IanFeldman/watch/hw/schematic.png

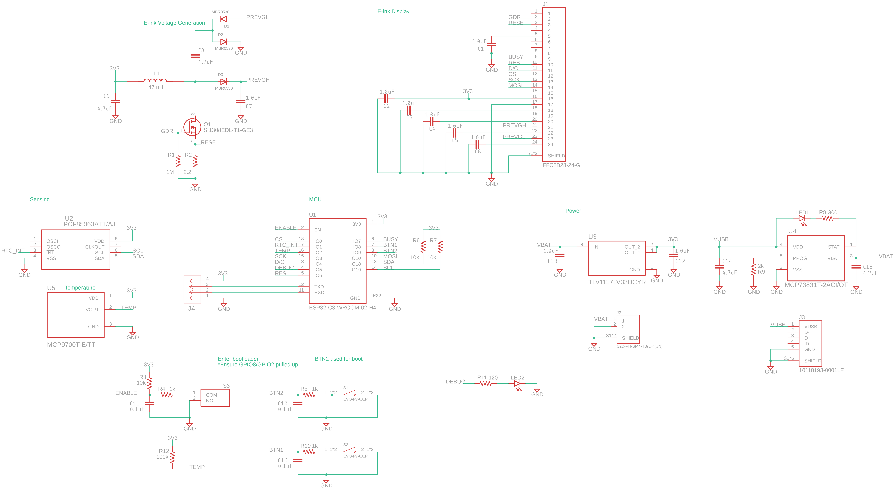
hw/schematic.png
