IanFeldman/watch/hw/v1.brd

## EAGLE design hw/v1.brd (2024-08-28)

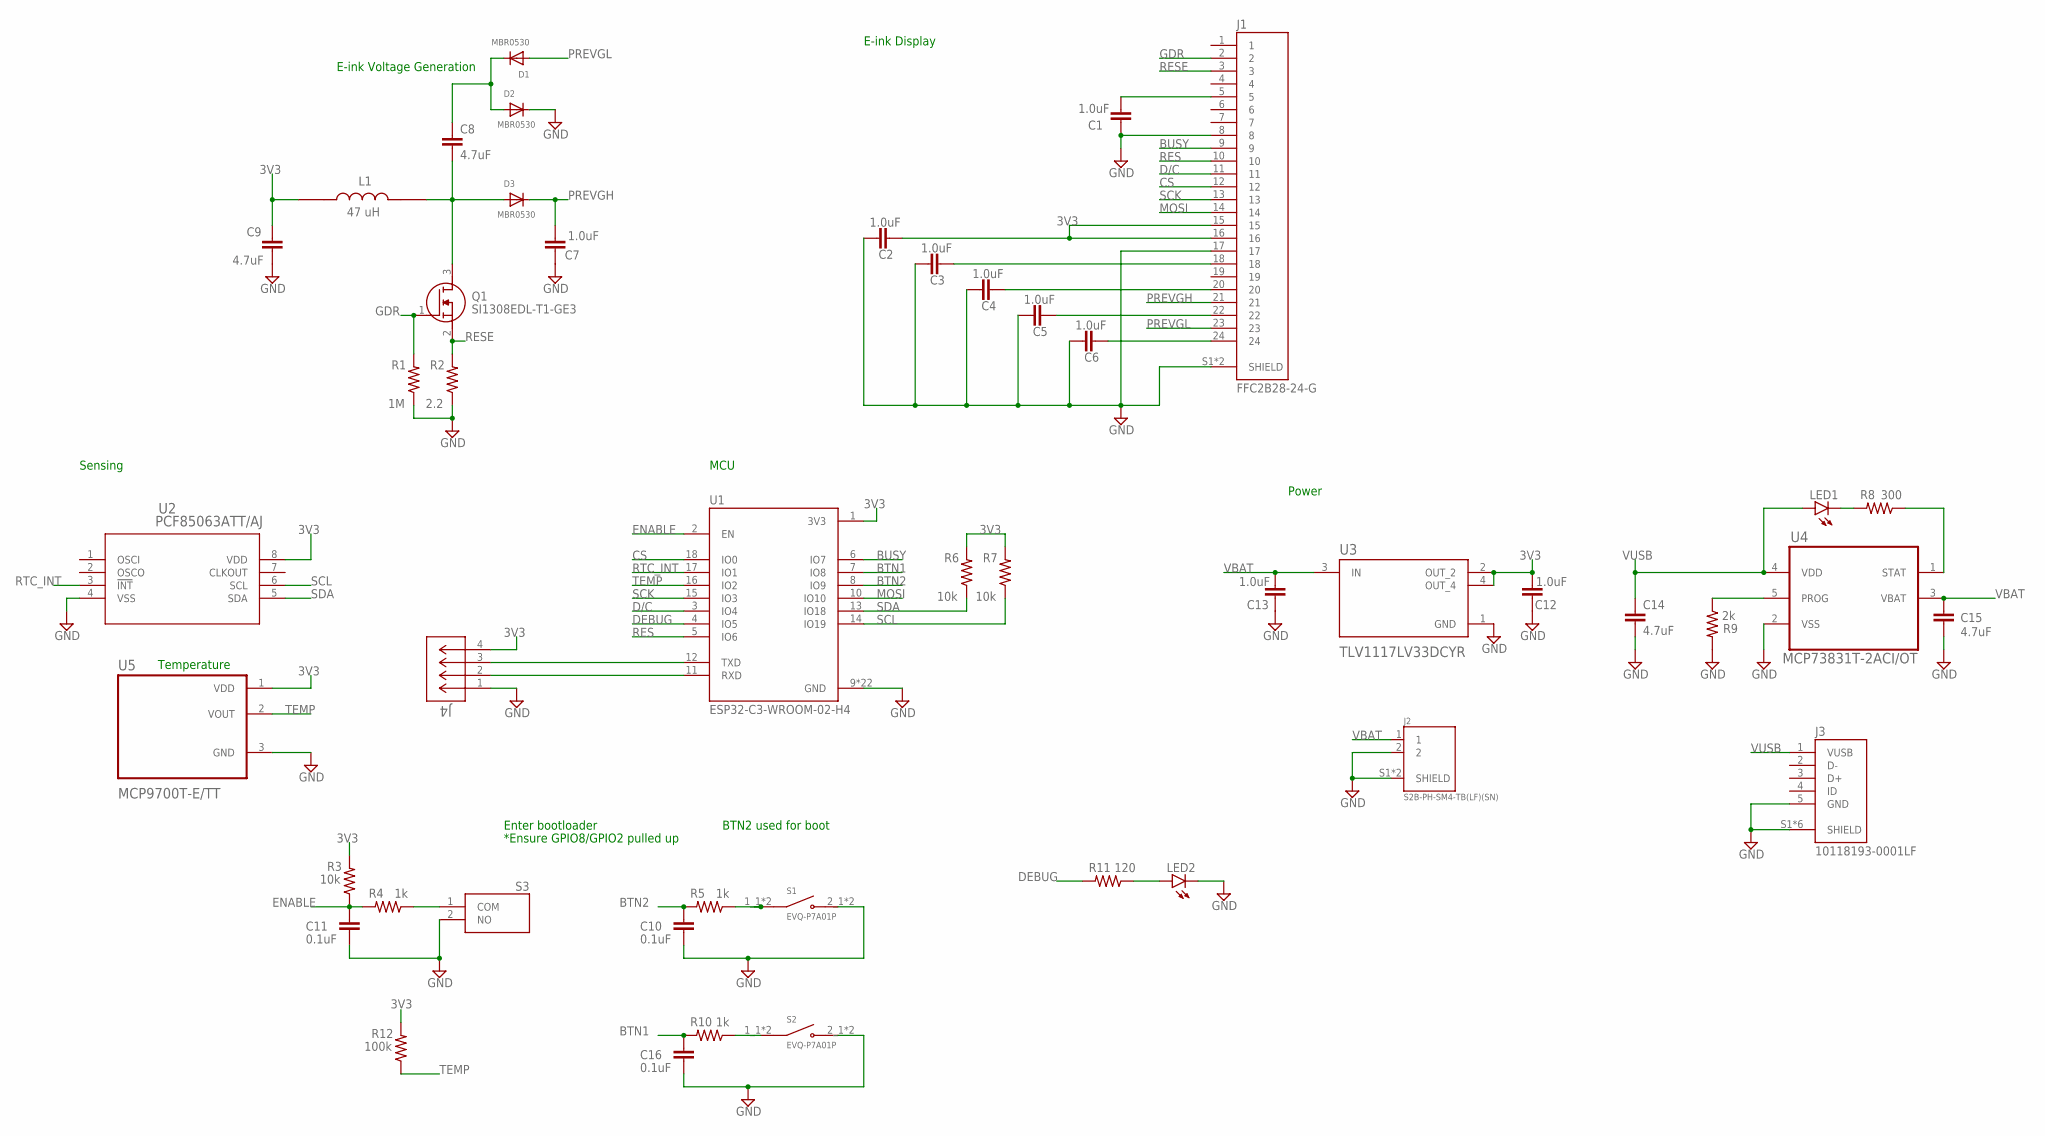
[picture p2: schematic v1.sch]

Parts:
C1, C2, C3, C4, C5, C6, C7, C12, C13: 1.0uF; 0603
C8, C9, C14, C15: 4.7uF; 0603
C10, C11, C16: 0.1uF; 0603
D1, D2, D3: MBR0530; SOD323F
J1: FFC2B28-24-G; GCT_FFC2B28-24-G
J2: S2B-PH-SM4-TB(LF)(SN); JST_S2B-PH-SM4-TB(LF)(SN)
J3: 10118193-0001LF; AMPHENOL_10118193-0001LF
J4: 851-43-004-20-001000; CONN_851-43-004-20-001000_MIM
L1: 47 uH; IND_ADL3225V-470MT-TL000
LED1, LED2: LEDCHIP-LED0603; CHIP-LED0603
Q1: SI1308EDL-T1-GE3; SOT65P210X110-3N
R1: 1M; R0603
R2: 2.2; R0603
R3, R6, R7: 10k; R0603
R4, R5, R10: 1k; R0603
R8: 300; R0603
R9: 2k; R0603
R11: 120; R0603
R12: 100k; R0603
S1, S2: EVQ-P7A01P; SW_EVQ-P7A01P
S3: PTS636_SM25F_SMTR_LFS; PTS636SM25FSMTRLFS
U1: ESP32-C3-WROOM-02-H4; MODULE_ESP32-C3-WROOM-02-H4
U2: PCF85063ATT/AJ; PCF85063ATT/AJ_NXP
U3: TLV1117LV33DCYR; VREG_TLV1117LV33DCYR
U4: MCP73831T-2ACI/OT; SOT95P280X145-5N
U5: MCP9700T-E/TT; SOT95P237X112-3N

Connections:
3V3: C2.1, C9.1, C12.1, J1.15, J1.16, J4.4, L1.1, R3.2, R6.2, R7.2, R12.2, U1.1 (3V3), U2.8 (VDD), U3.2 (OUT_2), U3.4 (OUT_4), U5.1 (VDD)
BTN1: C16.1, R10.2, U1.7 (IO8)
BTN2: C10.1, R5.2, U1.8 (IO9)
BUSY: J1.9, U1.6 (IO7)
CS: J1.12, U1.18 (IO0)
D/C: J1.11, U1.3 (IO4)
DEBUG: R11.2, U1.4 (IO5)
ENABLE: C11.1, R3.1, R4.2, U1.2 (EN)
GDR: J1.2, Q1.1 (G), R1.2
GND: C1.2, C2.2, C3.2, C4.2, C5.2, C6.2, C7.2, C9.2, C10.2, C11.2, C12.2, C13.2, C14.2, C15.2, C16.2, D2.C, J1.8, J1.17, J1.S1 (SHIELD), J1.S2 (SHIELD), J2.2, J2.S1 (SHIELD), J2.S2 (SHIELD), J3.5 (GND), J3.S1 (SHIELD), J3.S2 (SHIELD), J3.S3 (SHIELD), J3.S4 (SHIELD), J3.S5 (SHIELD), J3.S6 (SHIELD), J4.1, LED2.C, R1.1, R2.1, R9.2, S1.2_1 (2), S1.2_2 (2), S2.2_1 (2), S2.2_2 (2), S3.2 (NO), U1.9 (GND), U1.19 (GND), U1.20 (GND), U1.21 (GND), U1.22 (GND), U1.23 (GND), U1.24 (GND), U1.25 (GND), U1.26 (GND), U1.27 (GND), U1.28 (GND), U1.29 (GND), U1.30 (GND), U1.31 (GND), U1.32 (GND), U1.33 (GND), U1.34 (GND), U1.35 (GND), U1.36 (GND), U1.37 (GND), U1.38 (GND), U1.39 (GND), U2.4 (VSS), U3.1 (GND), U4.2 (VSS), U5.3 (GND)
MOSI: J1.14, U1.10 (IO10)
unnamed: C1.1, J1.5
unnamed: C3.1, J1.18
unnamed: C4.1, J1.20
unnamed: C5.1, J1.22
unnamed: C8.2, D3.A, L1.2, Q1.3 (D)
unnamed: C6.1, J1.24
unnamed: C8.1, D1.C, D2.A
unnamed: R4.1, S3.1 (COM)
unnamed: R5.1, S1.1_1 (1), S1.1_2 (1)
unnamed: R10.1, S2.1_1 (1), S2.1_2 (1)
unnamed: J4.3, U1.12 (TXD)
unnamed: J4.2, U1.11 (RXD)
unnamed: LED1.C, R8.2
unnamed: R8.1, U4.1 (STAT)
unnamed: R9.1, U4.5 (PROG)
unnamed: LED2.A, R11.1
PREVGH: C7.1, D3.C, J1.21
PREVGL: D1.A, J1.23
RES: J1.10, U1.5 (IO6)
RESE: J1.3, Q1.2 (S), R2.2
RTC_INT: U1.17 (IO1), U2.3 (!INT)
SCK: J1.13, U1.15 (IO3)
SCL: R7.1, U1.14 (IO19), U2.6 (SCL)
SDA: R6.1, U1.13 (IO18), U2.5 (SDA)
TEMP: R12.1, U1.16 (IO2), U5.2 (VOUT)
VBAT: C13.1, C15.1, J2.1, U3.3 (IN), U4.3 (VBAT)
VUSB: C14.1, J3.1 (VUSB), LED1.A, U4.4 (VDD)

Notes on the sheet:
E-ink Voltage Generation
Enter bootloader
*Ensure GPIO8/GPIO2 pulled up
Power
Sensing
MCU
E-ink Display
BTN2 used for boot
Temperature

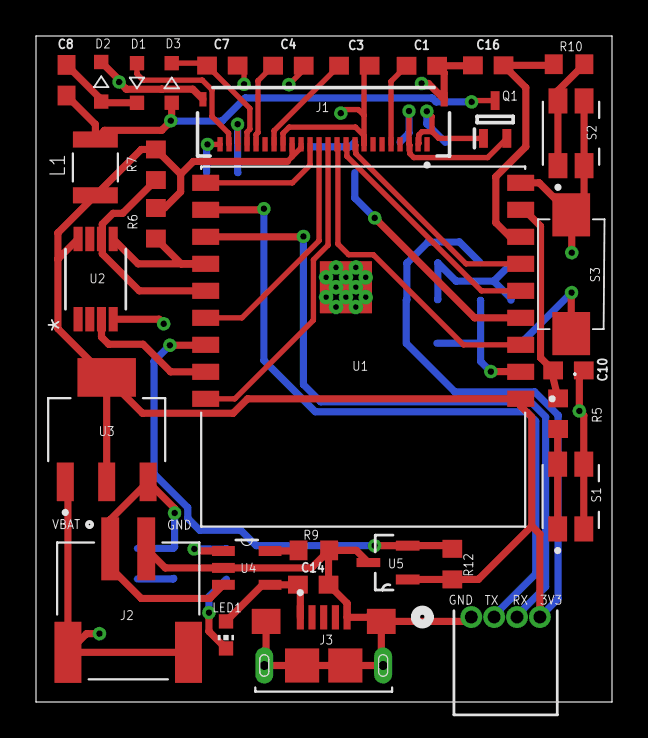
[picture p3: board v1.brd from above]

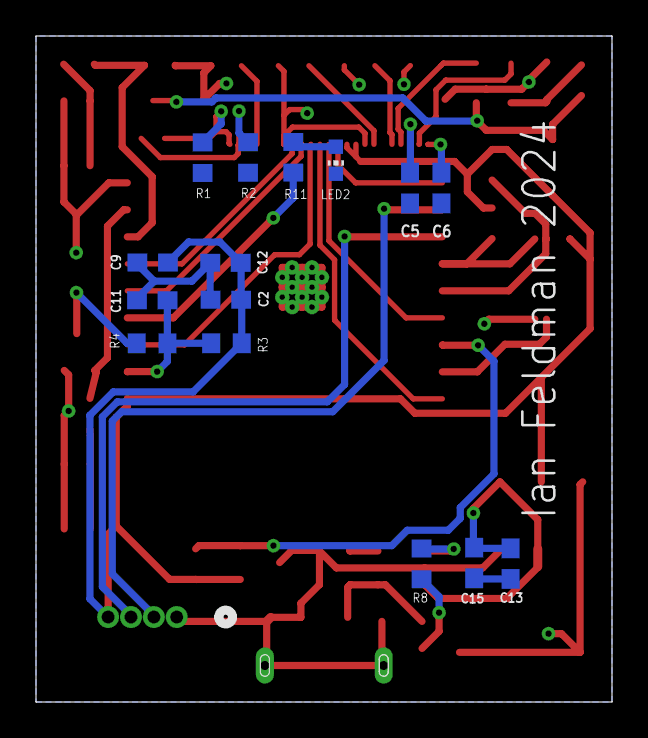
[picture p4: board v1.brd from below]

Board: 2 copper layers, 32.0 x 37.0 mm, 47 parts (15 on the bottom side), 38 nets.
