IanFeldman/watch/(commit log)

2024-08-20 Create display driver
2024-08-23 Add schematic, bill of materials
    [bom.csv, v1.sch]
2024-08-24 Add boot buttons, rtc, ldo
    [bom.csv, v1.sch]
2024-08-25 Add charging hardware, change buttons
    [bom.csv, v1.sch]
2024-08-25 Add usb to bom
    [bom.csv]
2024-08-25 Add board
    [v1.brd]
2024-08-25 Finish basic board layout, change reset button
    [bom.csv, v1.brd, v1.sch]
2024-08-26 Add temperature sensor
    [bom.csv, v1.brd, v1.sch]
2024-08-26 Change inductor, add part numbers to bom
    [bom.csv, v1.brd, v1.sch]
2024-08-27 Find passive parts, change led resistor to 300 ohm
    [bom.csv, v1.brd, v1.sch]
2024-08-27 Hw changes
    [bom.csv, v1.brd, v1.sch]
2024-08-28 Add text to board
    [v1.brd]
2024-08-28 Remove unnecessary text
    [v1.brd]
2024-08-28 Minor changes
    [v1.brd]
2024-08-28 Change esp32
    [bom.csv]
2024-08-29 Add schematic image
2024-08-29 Refactor display driver, style changes
2024-09-11 Put font images in array, fix write_to_ram bugs, add bit offset to bitwise scale
    [display.c, main.c, util.h]
2024-09-12 Rework bitwise scale function
    [display.c, util.h]
